sanlin19054-cyber/desktop-tutorial/vision/测试图片/组合2.jpg

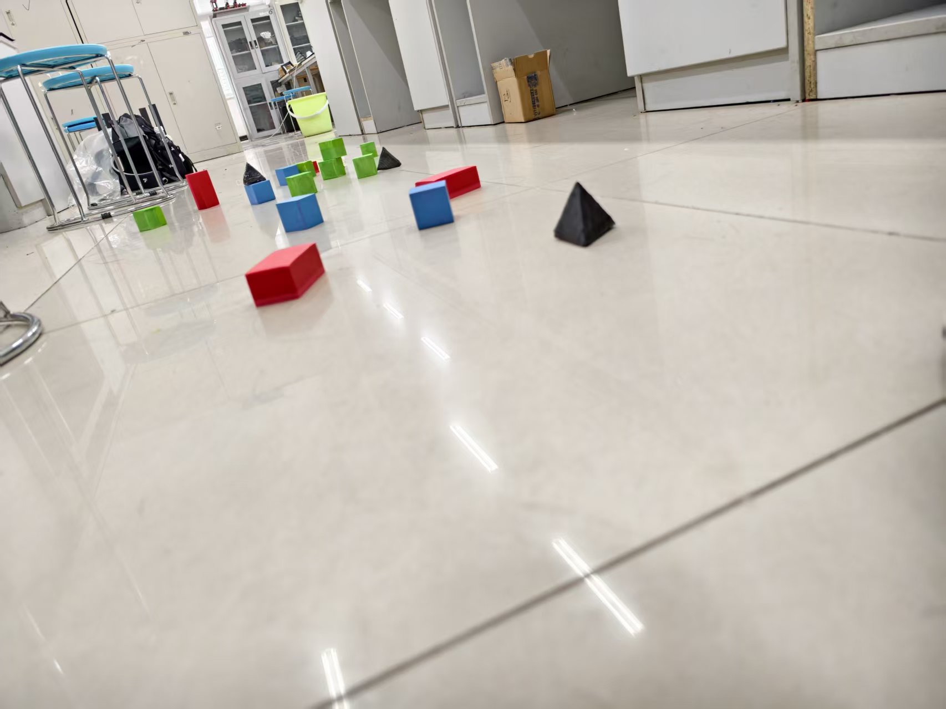
vision/测试图片/组合2.jpg
