sanlin19054-cyber/desktop-tutorial/vision/测试图片/组合3.jpg

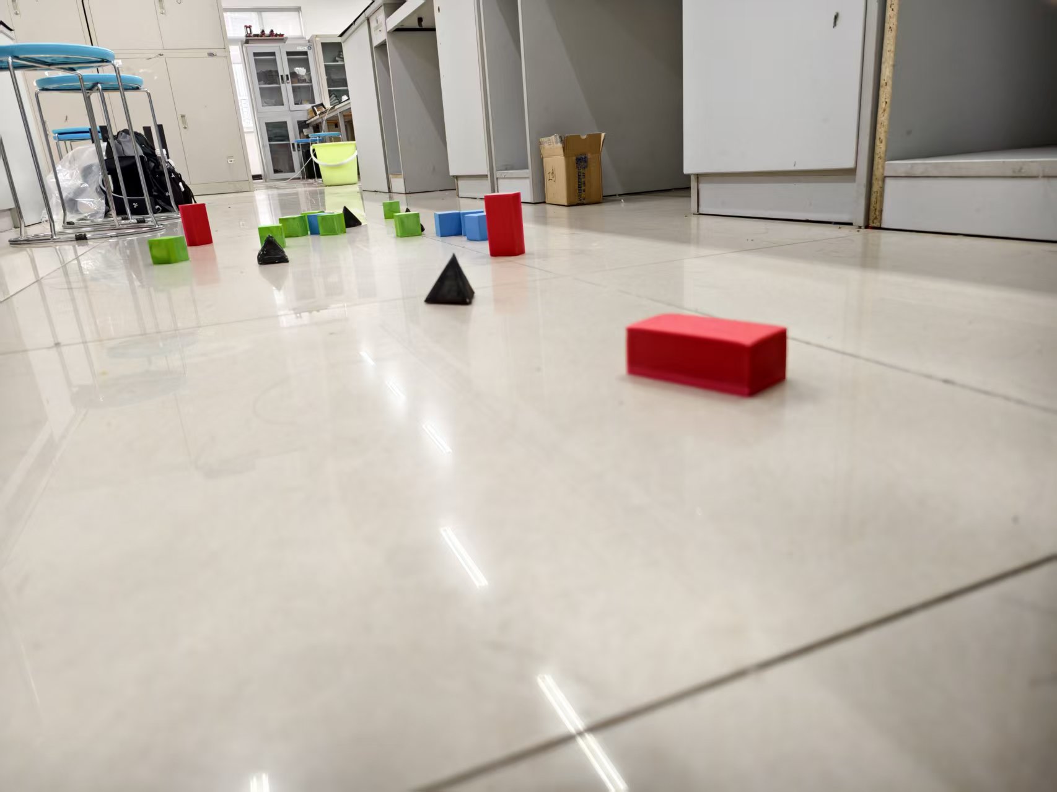
vision/测试图片/组合3.jpg
