sanlin19054-cyber/desktop-tutorial/integration/紅外測距調試記錄.md

 # 工創賽紅外測距調試記錄

> **日期**：2026年8月23日至2026年8月29日

> **主要事宜**：編碼並調試左、右紅外測距設備，測試證明成功。

> **說明**：第一次嘗試，各方面都很粗糙，所有內容僅供學習參考orz

---

## 8月23日 供电检查
### 內容概述
检查红外传感器供电线路，将VCC接系统电源、GND接系统地。
### 成果記錄
上电后传感器指示灯正常，供电电压稳定，未发现发热和接触不良现象。

---

## 8月24日 信号输出检查
### 内容概述
将红外传感器OUT接入STM32输入引脚，在传感器前方反复放置和移开障碍物。
### 成果记录
输出电平能够正常切换，STM32可以正确读取传感器状态。

---

## 8月25日 检测距离调整
### 内容概述
通过调节传感器灵敏度电位器，测试不同距离下的检测效果。
### 成果记录
调整后检测距离满足机器人使用要求，近距离触发稳定，无障碍时能够正常恢复。

---

## 8月26日 连续触发测试
### 内容概述
连续进行多次遮挡和移开测试，观察传感器输出及程序响应。
### 成果记录
传感器均能正常触发，未出现明显漏检，程序能够及时更新检测状态。

---

## 8月27日 环境光测试
### 内容概述
分别在室内照明、较暗环境和较强光线下进行测试。
### 成果记录
普通室内环境下工作稳定；强光照射时检测距离略有变化，重新调整灵敏度后恢复正常。

---

## 8月28日 抗干扰测试
### 内容概述
启动电机并同时读取红外传感器信号，检查电机工作对传感器的影响。
### 成果记录
发现偶尔出现短时波动，在程序中加入连续采样和简单滤波后，误触发现象明显减少。

---

## 8月29日 整机联调
### 内容概述
将红外传感器安装到机器人上，与STM32、电机驱动和控制程序进行整机测试。
### 成果概述
机器人能够根据红外检测结果执行相应动作，各传感器响应正常，系统整体运行稳定。
