sanlin19054-cyber/desktop-tutorial/vision/测试图片/组合1.jpg

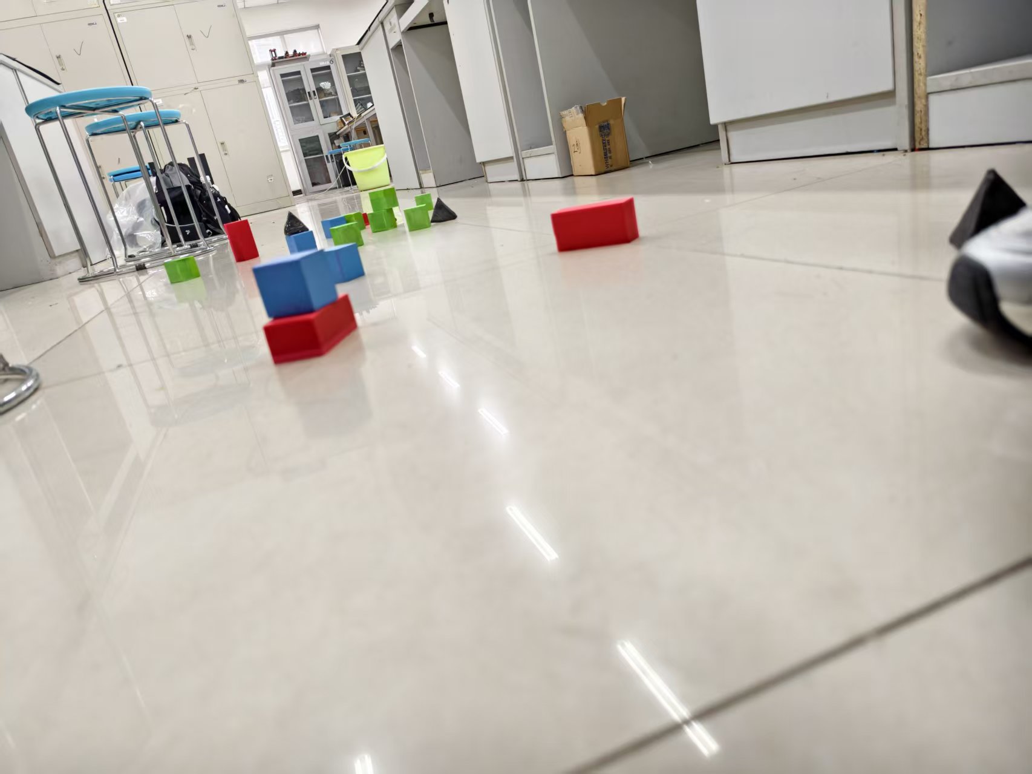
vision/测试图片/组合1.jpg
