sanlin19054-cyber/desktop-tutorial/hardware/STM32F1智能小车线束表.xlsx

Sheet: 线束总表
线号 | 类别 | 起点设备 | 起点引脚 | 起点信号 | 终点设备 | 终点引脚 | 终点信号 | 线材/连接形式 | 建议线色 | 长度 | 状态 | 备注
H1-01 | 板间排针 | 扩展板 H1 | 1 | VBAT | U1 | 20 | VBAT | 2.54mm 排针直插 | — | — | 图纸明确 | STM32 最小系统板与扩展板对应接口
H1-02 | 板间排针 | 扩展板 H1 | 2 | C13 | U1 | 19 | C13 | 2.54mm 排针直插 | — | — | 图纸明确 | STM32 最小系统板与扩展板对应接口
H1-03 | 板间排针 | 扩展板 H1 | 3 | C14 | U1 | 18 | C14 | 2.54mm 排针直插 | — | — | 图纸明确 | STM32 最小系统板与扩展板对应接口
H1-04 | 板间排针 | 扩展板 H1 | 4 | C15 | U1 | 17 | C15 | 2.54mm 排针直插 | — | — | 图纸明确 | STM32 最小系统板与扩展板对应接口
H1-05 | 板间排针 | 扩展板 H1 | 5 | A0 | U1 | 16 | A0 | 2.54mm 排针直插 | — | — | 图纸明确 | STM32 最小系统板与扩展板对应接口
H1-06 | 板间排针 | 扩展板 H1 | 6 | A1 | U1 | 15 | A1 | 2.54mm 排针直插 | — | — | 图纸明确 | STM32 最小系统板与扩展板对应接口
H1-07 | 板间排针 | 扩展板 H1 | 7 | A2 | U1 | 14 | A2 | 2.54mm 排针直插 | — | — | 图纸明确 | STM32 最小系统板与扩展板对应接口
H1-08 | 板间排针 | 扩展板 H1 | 8 | A3 | U1 | 13 | A3 | 2.54mm 排针直插 | — | — | 图纸明确 | STM32 最小系统板与扩展板对应接口
H1-09 | 板间排针 | 扩展板 H1 | 9 | A4 | U1 | 12 | A4 | 2.54mm 排针直插 | — | — | 图纸明确 | STM32 最小系统板与扩展板对应接口
H1-10 | 板间排针 | 扩展板 H1 | 10 | A5 | U1 | 11 | A5 | 2.54mm 排针直插 | — | — | 图纸明确 | STM32 最小系统板与扩展板对应接口
H1-11 | 板间排针 | 扩展板 H1 | 11 | A6 | U1 | 10 | A6 | 2.54mm 排针直插 | — | — | 图纸明确 | STM32 最小系统板与扩展板对应接口
H1-12 | 板间排针 | 扩展板 H1 | 12 | A7 | U1 | 9 | A7 | 2.54mm 排针直插 | — | — | 图纸明确 | STM32 最小系统板与扩展板对应接口
H1-13 | 板间排针 | 扩展板 H1 | 13 | B0 | U1 | 8 | B0 | 2.54mm 排针直插 | — | — | 图纸明确 | STM32 最小系统板与扩展板对应接口
H1-14 | 板间排针 | 扩展板 H1 | 14 | B1 | U1 | 7 | B1 | 2.54mm 排针直插 | — | — | 图纸明确 | STM32 最小系统板与扩展板对应接口
H1-15 | 板间排针 | 扩展板 H1 | 15 | B10 | U1 | 6 | B10 | 2.54mm 排针直插 | — | — | 图纸明确 | STM32 最小系统板与扩展板对应接口
H1-16 | 板间排针 | 扩展板 H1 | 16 | B11 | U1 | 5 | B11 | 2.54mm 排针直插 | — | — | 图纸明确 | STM32 最小系统板与扩展板对应接口
H1-17 | 板间排针 | 扩展板 H1 | 17 | RESET | U1 | 4 | RESET | 2.54mm 排针直插 | — | — | 图纸明确 | STM32 最小系统板与扩展板对应接口
H1-18 | 板间排针 | 扩展板 H1 | 18 | 3.3V | U1 | 3 | 3.3V | 2.54mm 排针直插 | — | — | 图纸明确 | STM32 最小系统板与扩展板对应接口
H1-19 | 板间排针 | 扩展板 H1 | 19 | GND | U1 | 2 | GND | 2.54mm 排针直插 | — | — | 图纸明确 | STM32 最小系统板与扩展板对应接口
H1-20 | 板间排针 | 扩展板 H1 | 20 | GND | U1 | 1 | GND | 2.54mm 排针直插 | — | — | 图纸明确 | STM32 最小系统板与扩展板对应接口
H2-01 | 板间排针 | 扩展板 H2 | 1 | B12 | U1 | 40 | B12 | 2.54mm 排针直插 | — | — | 图纸明确 | STM32 最小系统板与扩展板对应接口
H2-02 | 板间排针 | 扩展板 H2 | 2 | B13 | U1 | 39 | B13 | 2.54mm 排针直插 | — | — | 图纸明确 | STM32 最小系统板与扩展板对应接口
H2-03 | 板间排针 | 扩展板 H2 | 3 | B14 | U1 | 38 | B14 | 2.54mm 排针直插 | — | — | 图纸明确 | STM32 最小系统板与扩展板对应接口
H2-04 | 板间排针 | 扩展板 H2 | 4 | B15 | U1 | 37 | B15 | 2.54mm 排针直插 | — | — | 图纸明确 | STM32 最小系统板与扩展板对应接口
H2-05 | 板间排针 | 扩展板 H2 | 5 | A8 | U1 | 36 | A8 | 2.54mm 排针直插 | — | — | 图纸明确 | STM32 最小系统板与扩展板对应接口
H2-06 | 板间排针 | 扩展板 H2 | 6 | A9 | U1 | 35 | A9 | 2.54mm 排针直插 | — | — | 图纸明确 | STM32 最小系统板与扩展板对应接口
H2-07 | 板间排针 | 扩展板 H2 | 7 | A10 | U1 | 34 | A10 | 2.54mm 排针直插 | — | — | 图纸明确 | STM32 最小系统板与扩展板对应接口
H2-08 | 板间排针 | 扩展板 H2 | 8 | A11 | U1 | 33 | A11 | 2.54mm 排针直插 | — | — | 图纸明确 | STM32 最小系统板与扩展板对应接口
H2-09 | 板间排针 | 扩展板 H2 | 9 | A12 | U1 | 32 | A12 | 2.54mm 排针直插 | — | — | 图纸明确 | STM32 最小系统板与扩展板对应接口
H2-10 | 板间排针 | 扩展板 H2 | 10 | A15 | U1 | 31 | A15 | 2.54mm 排针直插 | — | — | 图纸明确 | STM32 最小系统板与扩展板对应接口
H2-11 | 板间排针 | 扩展板 H2 | 11 | B3 | U1 | 30 | B3 | 2.54mm 排针直插 | — | — | 图纸明确 | STM32 最小系统板与扩展板对应接口
H2-12 | 板间排针 | 扩展板 H2 | 12 | B4 | U1 | 29 | B4 | 2.54mm 排针直插 | — | — | 图纸明确 | STM32 最小系统板与扩展板对应接口
H2-13 | 板间排针 | 扩展板 H2 | 13 | B5 | U1 | 28 | B5 | 2.54mm 排针直插 | — | — | 图纸明确 | STM32 最小系统板与扩展板对应接口
H2-14 | 板间排针 | 扩展板 H2 | 14 | B6 | U1 | 27 | B6 | 2.54mm 排针直插 | — | — | 图纸明确 | STM32 最小系统板与扩展板对应接口
H2-15 | 板间排针 | 扩展板 H2 | 15 | B7 | U1 | 26 | B7 | 2.54mm 排针直插 | — | — | 图纸明确 | STM32 最小系统板与扩展板对应接口
H2-16 | 板间排针 | 扩展板 H2 | 16 | B8 | U1 | 25 | B8 | 2.54mm 排针直插 | — | — | 图纸明确 | STM32 最小系统板与扩展板对应接口
H2-17 | 板间排针 | 扩展板 H2 | 17 | B9 | U1 | 24 | B9 | 2.54mm 排针直插 | — | — | 图纸明确 | STM32 最小系统板与扩展板对应接口
H2-18 | 板间排针 | 扩展板 H2 | 18 | 5V | U1 | 23 | 5V | 2.54mm 排针直插 | — | — | 图纸明确 | STM32 最小系统板与扩展板对应接口
H2-19 | 板间排针 | 扩展板 H2 | 19 | GND | U1 | 22 | GND | 2.54mm 排针直插 | — | — | 图纸明确 | STM32 最小系统板与扩展板对应接口
H2-20 | 板间排针 | 扩展板 H2 | 20 | 3.3V | U1 | 21 | 3.3V | 2.54mm 排针直插 | — | — | 图纸明确 | STM32 最小系统板与扩展板对应接口
U2-1 | 显示 | 扩展板 U2 / 0.96 OLED | 1 | GND | OLED 模块 | 1 | GND | 4P 2.54mm | 黑 | 图纸未规定 | 待复核 | 模块引脚标注 GND；原理图未在该引脚处形成显式 GND 网络，装配前复核。
U2-2 | 显示 | 扩展板 U2 / 0.96 OLED | 2 | VCC | OLED 模块 | 2 | 5V | 4P 2.54mm | 红 | 图纸未规定 | 图纸明确
U2-3 | 显示 | 扩展板 U2 / 0.96 OLED | 3 | SCL | OLED 模块 | 3 | A11 | 4P 2.54mm | 黄/绿 | 图纸未规定 | 图纸明确
U2-4 | 显示 | 扩展板 U2 / 0.96 OLED | 4 | SDA | OLED 模块 | 4 | A12 | 4P 2.54mm | 黄/绿 | 图纸未规定 | 图纸明确
A1-2 | 蓝牙 | 扩展板 A1 / JDY-31 | 2 | RXD | JDY-31 模块 | 2 | A9 | 2.54mm | 信号色 | 图纸未规定 | 图纸明确
A1-3 | 蓝牙 | 扩展板 A1 / JDY-31 | 3 | TXD | JDY-31 模块 | 3 | A10 | 2.54mm | 信号色 | 图纸未规定 | 图纸明确
A1-4 | 蓝牙 | 扩展板 A1 / JDY-31 | 4 | GND | JDY-31 模块 | 4 | GND | 2.54mm | 黑 | 图纸未规定 | 图纸明确 | 原理图未形成从该引脚到 GND 网络的有效连线，请以实物/PCB复核。
A1-5 | 蓝牙 | 扩展板 A1 / JDY-31 | 5 | VCC | JDY-31 模块 | 5 | 5V | 2.54mm | 红 | 图纸未规定 | 图纸明确
A1-1 | 蓝牙 | 扩展板 A1 / JDY-31 | 1 | STATE | JDY-31 模块 | 1 | NC | 2.54mm | 信号色 | 图纸未规定 | 未接/待确认
A1-6 | 蓝牙 | 扩展板 A1 / JDY-31 | 6 | EN | JDY-31 模块 | 6 | NC | 2.54mm | 信号色 | 图纸未规定 | 未接/待确认
H9-2 | 树莓派串口 | 扩展板 H9 | 2 | A2 | 树莓派 | TX→树莓派 RX | TX→树莓派 RX | 2.54mm 3P | 信号色 | 图纸未规定 | 图纸明确 | 原理图文字明确标注“树莓派接口”；H9 的 A2/A3 对应串口信号。
H9-3 | 树莓派串口 | 扩展板 H9 | 3 | A3 | 树莓派 | RX←树莓派 TX | RX←树莓派 TX | 2.54mm 3P | 信号色 | 图纸未规定 | 图纸明确 | 原理图文字明确标注“树莓派接口”；H9 的 A2/A3 对应串口信号。
H9-1 | 树莓派串口 | 扩展板 H9 | 1 | NC | 树莓派 | 未定义 | 未定义 | 2.54mm 3P | 信号色 | 图纸未规定 | 未接/待确认 | H9 Pin1 在原理图中未定义；未提供明确 GND/5V。
H5-1 | 传感器/IO | 扩展板 H5 | 1 | A0 | 图纸未命名外设 | SIG | A0 | 图纸未规定 | 信号色 | 图纸未规定 | 图纸明确
H5-2 | 传感器/IO | 扩展板 H5 | 2 | 5V | 外部传感器 | VCC | 5V | 2.54mm 3P | 红 | 图纸未规定 | 图纸明确
H5-3 | 传感器/IO | 扩展板 H5 | 3 | NC | 外部传感器 | — | NC | 2.54mm 3P | — | 图纸未规定 | 未接/待确认
H7-1 | 传感器/IO | 扩展板 H7 | 1 | 5V | 外部模块 | VCC | 5V | 2.54mm 4P | 红 | 图纸未规定 | 图纸明确
H7-2 | 传感器/IO | 扩展板 H7 | 2 | A4 | 外部模块 | SIG | A4 | 2.54mm 4P | 信号色 | 图纸未规定 | 图纸明确
H7-3 | 传感器/IO | 扩展板 H7 | 3 | A5 | 外部模块 | SIG | A5 | 2.54mm 4P | 信号色 | 图纸未规定 | 图纸明确
H7-4 | 传感器/IO | 扩展板 H7 | 4 | NC | 外部模块 | — | NC | 2.54mm 4P | — | 图纸未规定 | 未接/待确认
H8-1 | 右避障/IO | 扩展板 H8 | 1 | 5V | 右侧避障模块 | VCC | 5V | 2.54mm 3P | 红 | 图纸未规定 | 图纸明确 | PCB丝印区域标注“右避障”。
H8-2 | 右避障/IO | 扩展板 H8 | 2 | NC | 右侧避障模块 | — | NC | 2.54mm 3P | — | 图纸未规定 | 未接/待确认
H8-3 | 右避障/IO | 扩展板 H8 | 3 | B12 | 右侧避障模块 | SIG | B12 | 2.54mm 3P | 信号色 | 图纸未规定 | 图纸明确 | PCB丝印区域标注“右避障”。
H6-1 | 左避障/IO | 扩展板 H6 | 1 | 5V | 左侧避障模块 | VCC | 5V | 2.54mm 3P | 红 | 图纸未规定 | 图纸明确 | PCB丝印区域标注“左避障”。
H6-2 | 左避障/IO | 扩展板 H6 | 2 | NC | 左侧避障模块 | — | NC | 2.54mm 3P | — | 图纸未规定 | 未接/待确认
H6-3 | 左避障/IO | 扩展板 H6 | 3 | B13 | 左侧避障模块 | SIG | B13 | 2.54mm 3P | 信号色 | 图纸未规定 | 图纸明确 | PCB丝印区域标注“左避障”。
CN6-1 | 多路IO | 扩展板 CN6 | 1 | 5V | 外部模块 | VCC | 5V | KF2510 6P | 红 | 图纸未规定 | 图纸明确
CN6-2 | 多路IO | 扩展板 CN6 | 2 | B0 | 外部模块 | SIG | B0 | KF2510 6P | 信号色 | 图纸未规定 | 图纸明确
CN6-3 | 多路IO | 扩展板 CN6 | 3 | B1 | 外部模块 | SIG | B1 | KF2510 6P | 信号色 | 图纸未规定 | 图纸明确
CN6-4 | 多路IO | 扩展板 CN6 | 4 | B10 | 外部模块 | SIG | B10 | KF2510 6P | 信号色 | 图纸未规定 | 图纸明确
CN6-5 | 多路IO | 扩展板 CN6 | 5 | B11 | 外部模块 | SIG | B11 | KF2510 6P | 信号色 | 图纸未规定 | 图纸明确
CN6-6 | 多路IO | 扩展板 CN6 | 6 | NC | 外部模块 | — | NC | KF2510 6P | — | 图纸未规定 | 未接/待确认
U11-1 | 电机驱动 | 扩展板 U11 / TB6612 | VM(1) | IN+ | TB6612 模块 | VM | IN+ | 动力电源 | 红 | 图纸未规定 | 图纸明确
U11-2 | 电机驱动 | 扩展板 U11 / TB6612 | VCC(2) | 5V | TB6612 模块 | VCC | 5V | 逻辑电源 | 红 | 图纸未规定 | 图纸明确
U11-3 | 电机驱动 | 扩展板 U11 / TB6612 | GND(3) | GND | TB6612 模块 | GND | GND | 地线 | 黑 | 图纸未规定 | 待复核 | 元件引脚标注 GND，但原理图未形成显式 GND 网络。
U11-4 | 电机输出 | 扩展板 U11 / TB6612 | AO1(4) | AO1 | U7/U8 电机接口 | Pin1 | AO1 | 动力线 | 按电机电流选型 | 图纸未规定 | 图纸明确 | U7 与 U8 的同名网络并联。
U11-5 | 电机输出 | 扩展板 U11 / TB6612 | AO2(5) | AO2 | U7/U8 电机接口 | Pin2 | AO2 | 动力线 | 按电机电流选型 | 图纸未规定 | 图纸明确 | U7 与 U8 的同名网络并联。
U11-6 | 电机输出 | 扩展板 U11 / TB6612 | BO2(6) | BO2 | U9/U10 电机接口 | 对应并联端 | BO2 | 动力线 | 按电机电流选型 | 图纸未规定 | 图纸明确 | U9 与 U10 的同名网络并联。
U11-7 | 电机输出 | 扩展板 U11 / TB6612 | BO1(7) | BO1 | U9/U10 电机接口 | 对应并联端 | BO1 | 动力线 | 按电机电流选型 | 图纸未规定 | 图纸明确 | U9 与 U10 的同名网络并联。
U11-8 | 电机驱动 | 扩展板 U11 / TB6612 | GND(8) | GND | TB6612 模块 | GND | GND | 地线 | 黑 | 图纸未规定 | 待复核 | 元件引脚标注 GND，但原理图未形成显式 GND 网络。
U11-9 | 电机驱动 | 扩展板 U11 / TB6612 | GND(9) | GND | TB6612 模块 | GND | GND | 地线 | 黑 | 图纸未规定 | 待复核 | 元件引脚标注 GND，但原理图未形成显式 GND 网络。
U11-10 | 控制 | 扩展板 U11 / TB6612 | PWMB(10) | A6 | STM32 | PA6 | A6 | 信号线 | 信号色 | 图纸未规定 | 图纸明确
U11-11 | 控制 | 扩展板 U11 / TB6612 | BIN2(11) | B8 | STM32 | PB8 | B8 | 信号线 | 信号色 | 图纸未规定 | 图纸明确
U11-12 | 控制 | 扩展板 U11 / TB6612 | BIN1(12) | B7 | STM32 | PB7 | B7 | 信号线 | 信号色 | 图纸未规定 | 图纸明确
U11-13 | 控制 | 扩展板 U11 / TB6612 | STBY(13) | 5V | TB6612 模块 | STBY | 5V | 逻辑线 | 红 | 图纸未规定 | 图纸明确
U11-14 | 控制 | 扩展板 U11 / TB6612 | AIN1(14) | B6 | STM32 | PB6 | B6 | 信号线 | 信号色 | 图纸未规定 | 图纸明确
U11-15 | 控制 | 扩展板 U11 / TB6612 | AIN2(15) | B5 | STM32 | PB5 | B5 | 信号线 | 信号色 | 图纸未规定 | 图纸明确
U11-16 | 控制 | 扩展板 U11 / TB6612 | PWMA(16) | A7 | STM32 | PA7 | A7 | 信号线 | 信号色 | 图纸未规定 | 图纸明确
U7-1 | 电机接口 | U7 | 1 | AO1 | 左/甲电机端 | A+ | AO1 | 2P 5.08mm | 动力线 | 图纸未规定 | 图纸明确
U7-2 | 电机接口 | U7 | 2 | AO2 | 左/甲电机端 | A- | AO2 | 2P 5.08mm | 动力线 | 图纸未规定 | 图纸明确
U8-1 | 电机接口 | U8 | 1 | AO1 | 左/甲电机端 | A+ | AO1 | 2P 5.08mm | 动力线 | 图纸未规定 | 图纸明确 | 与 U7 并联，同一 AO1 网络。
U8-2 | 电机接口 | U8 | 2 | AO2 | 左/甲电机端 | A- | AO2 | 2P 5.08mm | 动力线 | 图纸未规定 | 图纸明确 | 与 U7 并联，同一 AO2 网络。
U9-1 | 电机接口 | U9 | 1 | BO1 | 右/乙电机端 | B+ | BO1 | 2P 5.08mm | 动力线 | 图纸未规定 | 图纸明确 | 与 U10 的 BO1/BO2 网络并联；具体极性按实车电机转向校验。
U9-2 | 电机接口 | U9 | 2 | BO2 | 右/乙电机端 | B- | BO2 | 2P 5.08mm | 动力线 | 图纸未规定 | 图纸明确
U10-1 | 电机接口 | U10 | 1 | BO2 | 右/乙电机端 | B- | BO2 | 2P 5.08mm | 动力线 | 图纸未规定 | 图纸明确 | 与 U9 并联。
U10-2 | 电机接口 | U10 | 2 | BO1 | 右/乙电机端 | B+ | BO1 | 2P 5.08mm | 动力线 | 图纸未规定 | 图纸明确 | 与 U9 并联。
PWR-01 | 电源 | CN5 | 1 | 电池负极 / U3 IN- | U3 | IN-(2) | IN- | 动力电源线 | 黑 | 图纸未规定 | 图纸明确 | CN5 Pin1 与 U3 IN- 相连。
PWR-02 | 电源 | CN5 | 2 | 电池正极 | U5 | Pin1 | 开关输入 | 动力电源线 | 红 | 图纸未规定 | 图纸明确
PWR-03 | 电源 | U5 | Pin2 | IN+（开关后） | U3 | IN+(1) | IN+ | 动力电源线 | 红 | 图纸未规定 | 图纸明确 | 同一 IN+ 网络还供给 H4 Pin1 与 TB6612 VM。
PWR-04 | 电源 | U3 | OUT+ (3) | 5V | 5V 电源网络 | 5V | 5V | 电源 | 红 | 图纸未规定 | 图纸明确 | 5V 经扩展板分配到 H3/H5/H6/H7/H8/CN6/U2/A1/U11 等。
PWR-05 | 电源 | U3 | OUT- (4) | OUT- | 电源负端 | GND | GND | 电源 | 黑 | 图纸未规定 | 待复核 | 原理图中 U3 OUT- 未形成显式 GND 网络；PCB/实物装配前必须复核。
PWR-06 | 动力电源 | H4 | 1 | IN+ | TB6612 U11 | VM(1) | IN+ | 2P 2.54/5.08mm | 红 | 图纸未规定 | 图纸明确 | H4 Pin1 标注为 IN+，对应 TB6612 VM 网络。
PWR-07 | 动力电源 | H4 | 2 | NC | — | — | NC | 2P 2.54/5.08mm | — | — | 未接/待确认 | 原理图未给出有效网络。

Sheet: 接口定义
接口/器件 | 类型 | Pin | 信号/网络 | 功能/外接对象 | 状态 | 备注
H1 | STM32板间接口 | 1 | VBAT | U1 Pin20 | 明确 | 2.54mm 20P
H1 | STM32板间接口 | 2 | C13 | U1 Pin19 | 明确
H1 | STM32板间接口 | 3 | C14 | U1 Pin18 | 明确
H1 | STM32板间接口 | 4 | C15 | U1 Pin17 | 明确
H1 | STM32板间接口 | 5 | A0 | U1 Pin16 | 明确
H1 | STM32板间接口 | 6 | A1 | U1 Pin15 | 明确
H1 | STM32板间接口 | 7 | A2 | U1 Pin14 | 明确
H1 | STM32板间接口 | 8 | A3 | U1 Pin13 | 明确
H1 | STM32板间接口 | 9 | A4 | U1 Pin12 | 明确
H1 | STM32板间接口 | 10 | A5 | U1 Pin11 | 明确
H1 | STM32板间接口 | 11 | A6 | U1 Pin10 | 明确
H1 | STM32板间接口 | 12 | A7 | U1 Pin9 | 明确
H1 | STM32板间接口 | 13 | B0 | U1 Pin8 | 明确
H1 | STM32板间接口 | 14 | B1 | U1 Pin7 | 明确
H1 | STM32板间接口 | 15 | B10 | U1 Pin6 | 明确
H1 | STM32板间接口 | 16 | B11 | U1 Pin5 | 明确
H1 | STM32板间接口 | 17 | RESET | U1 Pin4 | 明确
H1 | STM32板间接口 | 18 | 3.3V | U1 Pin3 | 明确
H1 | STM32板间接口 | 19 | GND | U1 Pin2 | 明确
H1 | STM32板间接口 | 20 | GND | U1 Pin1 | 明确
H2 | STM32板间接口 | 1 | B12 | U1 Pin40 | 明确 | 2.54mm 20P
H2 | STM32板间接口 | 2 | B13 | U1 Pin39 | 明确
H2 | STM32板间接口 | 3 | B14 | U1 Pin38 | 明确
H2 | STM32板间接口 | 4 | B15 | U1 Pin37 | 明确
H2 | STM32板间接口 | 5 | A8 | U1 Pin36 | 明确
H2 | STM32板间接口 | 6 | A9 | U1 Pin35 | 明确
H2 | STM32板间接口 | 7 | A10 | U1 Pin34 | 明确
H2 | STM32板间接口 | 8 | A11 | U1 Pin33 | 明确
H2 | STM32板间接口 | 9 | A12 | U1 Pin32 | 明确
H2 | STM32板间接口 | 10 | A15 | U1 Pin31 | 明确
H2 | STM32板间接口 | 11 | B3 | U1 Pin30 | 明确
H2 | STM32板间接口 | 12 | B4 | U1 Pin29 | 明确
H2 | STM32板间接口 | 13 | B5 | U1 Pin28 | 明确
H2 | STM32板间接口 | 14 | B6 | U1 Pin27 | 明确
H2 | STM32板间接口 | 15 | B7 | U1 Pin26 | 明确
H2 | STM32板间接口 | 16 | B8 | U1 Pin25 | 明确
H2 | STM32板间接口 | 17 | B9 | U1 Pin24 | 明确
H2 | STM32板间接口 | 18 | 5V | U1 Pin23 | 明确
H2 | STM32板间接口 | 19 | GND | U1 Pin22 | 明确
H2 | STM32板间接口 | 20 | 3.3V | U1 Pin21 | 明确
U2 | 0.96 OLED | 1 | GND | OLED GND | 待复核 | PCB器件引脚标注 GND；原理图未显式拉到 GND 网络
U2 | 0.96 OLED | 2 | 5V | OLED VCC | 明确 | I²C模块
U2 | 0.96 OLED | 3 | A11 | OLED SCL | 明确 | I²C
U2 | 0.96 OLED | 4 | A12 | OLED SDA | 明确 | I²C
A1 | JDY-31 | 1 | STATE | 状态脚 | 未接/待确认
A1 | JDY-31 | 2 | A9 | RXD | 明确
A1 | JDY-31 | 3 | A10 | TXD | 明确
A1 | JDY-31 | 4 | GND | GND | 待复核 | 模块脚标为 GND；原理图未显式接 GND
A1 | JDY-31 | 5 | 5V | VCC | 明确
A1 | JDY-31 | 6 | EN | 使能脚 | 未接/待确认
H9 | 树莓派接口 | 1 | NC | 未定义 | 未接/待确认
H9 | 树莓派接口 | 2 | A2 | TX→树莓派RX | 明确
H9 | 树莓派接口 | 3 | A3 | RX←树莓派TX | 明确
U11 | TB6612FNG | 1 | IN+ / VM | 动力电源 | 明确
U11 | TB6612FNG | 2 | 5V / VCC | 逻辑电源 | 明确
U11 | TB6612FNG | 3 | GND | 逻辑地 | 待复核 | 图中未形成显式 GND 网络
U11 | TB6612FNG | 4 | AO1 | A路电机 | 明确
U11 | TB6612FNG | 5 | AO2 | A路电机 | 明确
U11 | TB6612FNG | 6 | BO2 | B路电机 | 明确
U11 | TB6612FNG | 7 | BO1 | B路电机 | 明确
U11 | TB6612FNG | 8 | GND | 动力地 | 待复核 | 图中未形成显式 GND 网络
U11 | TB6612FNG | 9 | GND | 动力地 | 待复核 | 图中未形成显式 GND 网络
U11 | TB6612FNG | 10 | A6 | PWMB | 明确
U11 | TB6612FNG | 11 | B8 | BIN2 | 明确
U11 | TB6612FNG | 12 | B7 | BIN1 | 明确
U11 | TB6612FNG | 13 | 5V | STBY | 明确
U11 | TB6612FNG | 14 | B6 | AIN1 | 明确
U11 | TB6612FNG | 15 | B5 | AIN2 | 明确
U11 | TB6612FNG | 16 | A7 | PWMA | 明确

Sheet: 图纸复核
编号 | 对象 | 问题/现象 | 线束处理建议 | 优先级
R01 | U2 OLED Pin1 | 引脚标注 GND，但原理图连接未形成显式 GND 网络 | 装配时确认模块 Pin1 确实接系统 GND；不要仅依据原理图裸连 | 高
R02 | A1 JDY-31 Pin4 | 引脚标注 GND，但原理图未形成显式 GND 网络 | 必须在实物接线前复核 GND；与 STM32/扩展板共地 | 高
R03 | U11 TB6612 Pin3/8/9 | 三个引脚标注 GND，但原理图未形成显式 GND 网络 | 确认 PCB/模块实际已接 GND；否则驱动器无法正常工作 | 高
R04 | U3 OUT- | 5V 降压模块 OUT- 未形成显式 GND 网络 | 确认 OUT- 与系统 GND 的关系；上电前必须复核 | 高
R05 | H5/H6/H8/H7/H9/CN6 等 NC | 部分接口存在未定义/未连接引脚 | 按当前图纸视为 NC；如实物模块需要 GND/电源，必须先更新原理图再装配 | 中
R06 | U7/U8、U9/U10 | 两组电机端子为并联网络 | 同一电机回路不要同时插入两个并联端子；确认电机极性后统一编号 | 中
R07 | CN5/U5/U3/H4/U11 | 动力电源链路存在 IN+ 分配 | 建议在实物线束上给电池正极、开关后正极、驱动 VM 分别做标签 | 中
R08 | 线长/线径/颜色 | 原始图纸未给出线长、线径、线色 | 本表给出的是装配建议；最终尺寸应按车体实装测量、按负载电流选线径 | 中
