sanlin19054-cyber/desktop-tutorial/hardware/BOM_STM32F1智能小车扩展板_2026-08-18.csv

ID | Name | Designator | Footprint | Quantity | Manufacturer Part | Manufacturer | Supplier | Supplier Part | Price
1 | JDY-31(6针) | A1 | JDY-31(针2.54) | 1 |  |  | 16LAB
2 | 220uF | C4 | CAP-TH_BD10.0-P5.00-D1.0-RNG221M1EBK-1012 | 1
3 | 100nF | C5,C6 | C0805 | 2 | C0805B104J250NT | TORCH(火炬) | LCSC | C17702771 | 0.0504
4 | HDR-F-2.54_1x2 | CN5 | CONN-TH_KF2510-2P | 1 |  |  | LCSC | C49661 | 0.3984
5 | KH-2.54FH-1X6P-H8.5 | CN6 | CONN-TH_KF2510-6P | 1 | KH-2.54FH-1X6P-H8.5 | kinghelm(金航标) | LCSC | C2905416 | 0.5874
6 | KH-2.54FH-1X20P-H8.5 | H1,H2 | HDR-TH_20P-P2.54-V-F-2 | 2 | KH-2.54FH-1X20P-H8.5 | kinghelm(金航标) | LCSC | C2905423 | 1.5096
7 | H3 | H3 | HDR-M-2.54_2X5 | 1 | 1761683-3 | TE Connectivity(泰科电子) | LCSC | C17200487 | 19.85
8 | HDR-F-2.54_1x2 | H4,U7,U8,U9,U10 | CONN-TH_2P-P5.08_HX50801-2A | 5 |  |  | LCSC | C49661 | 0.3984
9 | XY-2.54-1*3PZ | H5,H6,H8,H9 | HDR-TH_XY-2.54-1X3PZ | 4 | XY-2.54-1*3PZ | XYECONN(辛译) | LCSC | C54110157 | 0.0779
10 | H7 | H7 | HDR-M-2.54_1X4 | 1 | KH-2.54FH-1X4P-H8.5 | kinghelm(金航标) | LCSC | C2905415 | 0.5118
11 | 4.7kΩ | R1,R2 | R0805 | 2 | RMC08054.7K1%N | Tyohm(幸亚电阻) | LCSC | C269746 | 0.0471
12 | STM32F103C8T6最小系统板原理图 | U1 | STM32F103C8T6最小系统板PCB图 | 1 |  |  | LCSC
13 | 0.96OLED_4P_MODULE_JX | U2 | 0.96OLED_4P | 1 | 0.96OLED_4P_MODULE_JX | null | LCSC | C9900004566
14 | MINI5605V5A输出电源模块 | U3 | COMM-SMD_MINI5605V5A | 1 | mini5605V5A输出电源模块 | null | LCSC | C9900015474
15 | HX SS12D10G5-WJ | U5 | SW-TH_3P-P4.80_HX-SS12D10G5-WJ | 1 | HX SS12D10G5-WJ | hanxia(韩下) | LCSC | C19189124 | 1.2893
16 | TB6612FNG_Module | U11 | TB6612FNG_MODULE | 1
