sanlin19054-cyber/desktop-tutorial/integration/rescue_robot_f407_ir_final_20260823/main.c

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
/* Includes ------------------------------------------------------------------*/
#include "main.h"
#include "dma.h"
#include "tim.h"
#include "usart.h"
#include "gpio.h"

/* USER CODE BEGIN Includes */
#include "pi_protocol.h"
#include "stp23l.h"
/* USER CODE END Includes */


/* USER CODE BEGIN PV */
static uint32_t telemetry_tick = 0;
static PiProtocol pi_protocol;
static uint8_t pi_motor_command_active = 0U;
static Stp23l stp_left;
static Stp23l stp_right;

#define STP23L_TELEMETRY_MAX_AGE_MS 300U

/* ST-LINK debugger watch variables. 0xFFFF means invalid or stale. */
volatile uint16_t stp_left_distance_mm = STP23L_INVALID_DISTANCE_MM;
volatile uint16_t stp_right_distance_mm = STP23L_INVALID_DISTANCE_MM;
volatile uint8_t stp_distance_valid_mask = 0U;
volatile uint8_t stp_left_confidence = 0U;
volatile uint8_t stp_right_confidence = 0U;
volatile uint32_t stp_left_frame_count = 0U;
volatile uint32_t stp_right_frame_count = 0U;
volatile uint32_t stp_left_invalid_frame_count = 0U;
volatile uint32_t stp_right_invalid_frame_count = 0U;
volatile uint32_t stp_left_uart_error_count = 0U;
volatile uint32_t stp_right_uart_error_count = 0U;
/* USER CODE END PV */

void SystemClock_Config(void);
/* USER CODE BEGIN 0 */
#define MOTOR_MAX_CMD 1000

/**
 * Command range: -1000 to 1000.
 * Positive drives forward, negative drives backward, zero stops.
 */
static void Motor_WritePair(TIM_HandleTypeDef *htim,
                            uint32_t channel_a,
                            uint32_t channel_b,
                            int16_t command)
{
    uint32_t pulse;
    uint32_t arr = __HAL_TIM_GET_AUTORELOAD(htim);

    if (command > MOTOR_MAX_CMD)
        command = MOTOR_MAX_CMD;
    else if (command < -MOTOR_MAX_CMD)
        command = -MOTOR_MAX_CMD;

    if (command > 0)
    {
        pulse = ((uint32_t)command * arr) / MOTOR_MAX_CMD;

        __HAL_TIM_SET_COMPARE(htim, channel_a, pulse);
        __HAL_TIM_SET_COMPARE(htim, channel_b, 0);
    }
    else if (command < 0)
    {
        pulse = ((uint32_t)(-command) * arr) / MOTOR_MAX_CMD;

        __HAL_TIM_SET_COMPARE(htim, channel_a, 0);
        __HAL_TIM_SET_COMPARE(htim, channel_b, pulse);
    }
    else
    {
        /* Set both bridge inputs to zero to stop the motor. */
        __HAL_TIM_SET_COMPARE(htim, channel_a, 0);
        __HAL_TIM_SET_COMPARE(htim, channel_b, 0);
    }
}

static void Motor_Set(uint8_t motor_id, int16_t command)
{
    switch (motor_id)
    {
        case 1:
            Motor_WritePair(&htim1,
                            TIM_CHANNEL_1,
                            TIM_CHANNEL_2,
                            command);
            break;

        case 2:
            Motor_WritePair(&htim1,
                            TIM_CHANNEL_3,
                            TIM_CHANNEL_4,
                            command);
            break;

        case 3:
            Motor_WritePair(&htim8,
                            TIM_CHANNEL_1,
                            TIM_CHANNEL_2,
                            command);
            break;

        default:
            break;
    }
}

static void Motor_StopAll(void)
{
    Motor_Set(1, 0);
    Motor_Set(2, 0);
    Motor_Set(3, 0);
}


/* Encoder debug values visible in the debugger. */
volatile int32_t encoder_delta_1 = 0;
volatile int32_t encoder_delta_2 = 0;
volatile int32_t encoder_delta_3 = 0;

static uint32_t encoder_last_1 = 0;
static uint16_t encoder_last_2 = 0;
static uint16_t encoder_last_3 = 0;
static uint32_t encoder_sample_tick = 0;

static void Encoder_Update(void)
{
    uint32_t now_1;
    uint16_t now_2;
    uint16_t now_3;

    /* TIM2 is a 32-bit timer. */
    now_1 = __HAL_TIM_GET_COUNTER(&htim2);
    encoder_delta_1 = (int32_t)(now_1 - encoder_last_1);
    encoder_last_1 = now_1;

    /* The int16_t conversion handles TIM3/TIM4 16-bit wraparound. */
    now_2 = (uint16_t)__HAL_TIM_GET_COUNTER(&htim3);
    encoder_delta_2 = (int16_t)(now_2 - encoder_last_2);
    encoder_last_2 = now_2;

    now_3 = (uint16_t)__HAL_TIM_GET_COUNTER(&htim4);
    encoder_delta_3 = (int16_t)(now_3 - encoder_last_3);
    encoder_last_3 = now_3;
}
/* USER CODE END 0 */

/**
  * @brief  The application entry point.
  * @retval int
  */
int main(void)
{
  /* MCU Configuration--------------------------------------------------------*/

  /* Reset of all peripherals, Initializes the Flash interface and the Systick. */
  HAL_Init();

  /* Configure the system clock */
  SystemClock_Config();

  /* Initialize all configured peripherals */
  MX_GPIO_Init();
  MX_DMA_Init();
  MX_TIM1_Init();
  MX_TIM2_Init();
  MX_TIM3_Init();
  MX_TIM4_Init();
  MX_TIM8_Init();
  MX_USART1_UART_Init();
  MX_USART2_UART_Init();
  MX_USART3_UART_Init();
  /* USER CODE BEGIN 2 */
  /* Keep all PWM outputs at zero to prevent movement at power-up. */
  __HAL_TIM_SET_COMPARE(&htim1, TIM_CHANNEL_1, 0);
  __HAL_TIM_SET_COMPARE(&htim1, TIM_CHANNEL_2, 0);
  __HAL_TIM_SET_COMPARE(&htim1, TIM_CHANNEL_3, 0);
  __HAL_TIM_SET_COMPARE(&htim1, TIM_CHANNEL_4, 0);
  __HAL_TIM_SET_COMPARE(&htim8, TIM_CHANNEL_1, 0);
  __HAL_TIM_SET_COMPARE(&htim8, TIM_CHANNEL_2, 0);

  /* Start six PWM channels. */
  HAL_TIM_PWM_Start(&htim1, TIM_CHANNEL_1);
  HAL_TIM_PWM_Start(&htim1, TIM_CHANNEL_2);
  HAL_TIM_PWM_Start(&htim1, TIM_CHANNEL_3);
  HAL_TIM_PWM_Start(&htim1, TIM_CHANNEL_4);
  HAL_TIM_PWM_Start(&htim8, TIM_CHANNEL_1);
  HAL_TIM_PWM_Start(&htim8, TIM_CHANNEL_2);
  /* Start three encoder interfaces. */
  HAL_TIM_Encoder_Start(&htim2, TIM_CHANNEL_ALL);
  HAL_TIM_Encoder_Start(&htim3, TIM_CHANNEL_ALL);
  HAL_TIM_Encoder_Start(&htim4, TIM_CHANNEL_ALL);

  Motor_StopAll();

  encoder_last_1 = __HAL_TIM_GET_COUNTER(&htim2);
  encoder_last_2 = (uint16_t)__HAL_TIM_GET_COUNTER(&htim3);
  encoder_last_3 = (uint16_t)__HAL_TIM_GET_COUNTER(&htim4);
  encoder_sample_tick = HAL_GetTick();
  PiProtocol_Init(&pi_protocol, &huart1);
  if (PiProtocol_Start(&pi_protocol) != HAL_OK)
  {
      Error_Handler();
  }
  Stp23l_Init(&stp_left, &huart2);
  Stp23l_Init(&stp_right, &huart3);
  if (Stp23l_Start(&stp_left) != HAL_OK)
  {
      Error_Handler();
  }
  if (Stp23l_Start(&stp_right) != HAL_OK)
  {
      Error_Handler();
  }
  /* USER CODE END 2 */

  /* Infinite loop */
  /* USER CODE BEGIN WHILE */
  while (1)
  {
    /* USER CODE END WHILE */

    /* USER CODE BEGIN 3 */
	  {
	      uint32_t now_ms = HAL_GetTick();
	      uint8_t valid_mask = 0U;
	      uint16_t left_distance = STP23L_INVALID_DISTANCE_MM;
	      uint16_t right_distance = STP23L_INVALID_DISTANCE_MM;

	      Stp23l_Service(&stp_left);
	      Stp23l_Service(&stp_right);
	      if (
	          Stp23l_GetDistance(
	              &stp_left,
	              now_ms,
	              STP23L_TELEMETRY_MAX_AGE_MS,
	              &left_distance
	          ) != 0U
	      )
	      {
	          valid_mask |= 0x01U;
	      }
	      if (
	          Stp23l_GetDistance(
	              &stp_right,
	              now_ms,
	              STP23L_TELEMETRY_MAX_AGE_MS,
	              &right_distance
	          ) != 0U
	      )
	      {
	          valid_mask |= 0x02U;
	      }
	      stp_left_distance_mm = left_distance;
	      stp_right_distance_mm = right_distance;
	      stp_distance_valid_mask = valid_mask;
	      stp_left_confidence = stp_left.confidence;
	      stp_right_confidence = stp_right.confidence;
	      stp_left_frame_count = stp_left.frame_count;
	      stp_right_frame_count = stp_right.frame_count;
	      stp_left_invalid_frame_count = stp_left.invalid_frame_count;
	      stp_right_invalid_frame_count = stp_right.invalid_frame_count;
	      stp_left_uart_error_count = stp_left.uart_error_count;
	      stp_right_uart_error_count = stp_right.uart_error_count;
	  }
	  if ((HAL_GetTick() - encoder_sample_tick) >= 10)
	  	  {
	  	      encoder_sample_tick = HAL_GetTick();
	  	      Encoder_Update();
	  	  }
      {
          PiMotorCommand command;
          if (PiProtocol_TakeMotorCommand(&pi_protocol, &command) != 0U)
          {
              Motor_Set(1, command.motor_1);
              Motor_Set(2, command.motor_2);
              Motor_Set(3, command.motor_3);
              pi_motor_command_active =
                  ((command.motor_1 != 0) ||
                   (command.motor_2 != 0) ||
                   (command.motor_3 != 0)) ? 1U : 0U;
          }

          if (
              (pi_motor_command_active != 0U) &&
              (PiProtocol_IsMotorCommandExpired(
                  &pi_protocol,
                  HAL_GetTick()
              ) != 0U)
          )
          {
              Motor_StopAll();
              pi_motor_command_active = 0U;
          }
      }
	  if ((HAL_GetTick() - telemetry_tick) >= 100)
	  {
	      telemetry_tick = HAL_GetTick();
          (void)PiProtocol_SendEncoderTelemetry(
              &pi_protocol,
              encoder_delta_1,
              encoder_delta_2,
              encoder_delta_3
          );
          (void)PiProtocol_SendDistanceTelemetry(
              &pi_protocol,
              stp_left_distance_mm,
              stp_right_distance_mm,
              stp_distance_valid_mask
          );
	  }
  }
  /* USER CODE END 3 */
}

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
/* USER CODE BEGIN 4 */
void HAL_UART_RxCpltCallback(UART_HandleTypeDef *huart)
{
    if (huart == &huart1)
    {
        PiProtocol_OnRxComplete(&pi_protocol, huart);
    }
    else
    {
        Stp23l_OnRxComplete(&stp_left, huart);
        Stp23l_OnRxComplete(&stp_right, huart);
    }
}

void HAL_UART_RxHalfCpltCallback(UART_HandleTypeDef *huart)
{
    Stp23l_OnRxHalfComplete(&stp_left, huart);
    Stp23l_OnRxHalfComplete(&stp_right, huart);
}

void HAL_UART_ErrorCallback(UART_HandleTypeDef *huart)
{
    if (huart == &huart1)
    {
        PiProtocol_OnUartError(&pi_protocol, huart);
    }
    else
    {
        Stp23l_OnUartError(&stp_left, huart);
        Stp23l_OnUartError(&stp_right, huart);
    }
}

/* USER CODE END 4 */
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
