sanlin19054-cyber/desktop-tutorial/electrical/Trace/Trace.h

#ifndef __Trace_H
#define __Trace_H

#define X1 GPIO_ReadInputDataBit(GPIOB,GPIO_Pin_0)
#define X2 GPIO_ReadInputDataBit(GPIOB,GPIO_Pin_1)
#define X3 GPIO_ReadInputDataBit(GPIOB,GPIO_Pin_10)
#define X4 GPIO_ReadInputDataBit(GPIOB,GPIO_Pin_11)

void Trace_Init(void);

#endif
