sanlin19054-cyber/desktop-tutorial/electrical/PWM/TIM3_PWM.c

#include "TIM3_PWM.h"
#include "MOTOR.h"


/**** TIM3 配置定时器通道1、2输出PWM方波 ***

*** 功能：实现电机调速 ***

*** PWM频率：5KHz ***

*** 修改占空比函数：TIM_SetComparex(TIMx,xxx); ***

*** 接口：
					PWMA--PA7（左电机）     PWMB--PA6（右电机）   

*** 作者：陈加油嗯 ***

***关注微信公众号学习更多单片机知识：微信搜索“陈加油嗯” ***

*/
void TIM3_PWM_Init(u16 arr,u16 psc)
{  
	GPIO_InitTypeDef GPIO_InitStructure;
	TIM_TimeBaseInitTypeDef  TIM_TimeBaseStructure;
	TIM_OCInitTypeDef  TIM_OCInitStructure;
	
	RCC_APB1PeriphClockCmd(RCC_APB1Periph_TIM3, ENABLE);	//使能定时器3时钟
 	RCC_APB2PeriphClockCmd(RCC_APB2Periph_GPIOA, ENABLE);  //使能GPIO外设
	
	//GPIO_PinRemapConfig(GPIO_PartialRemap_TIM3, ENABLE); //Timer3部分重映射  TIM3_CH2->PB5    
 
   //初始化输出TIM3两个通道PWM脉冲波形的引脚(CH1->PA6 CH2->PA7)
	GPIO_InitStructure.GPIO_Pin = GPIO_Pin_6|GPIO_Pin_7; //TIM3_CH1、CH2
	GPIO_InitStructure.GPIO_Mode = GPIO_Mode_AF_PP;  //复用推挽输出
	GPIO_InitStructure.GPIO_Speed = GPIO_Speed_50MHz;
	GPIO_Init(GPIOA, &GPIO_InitStructure);//初始化GPIO
 
   //初始化TIM3
	TIM_TimeBaseStructure.TIM_Period = arr; //设置在下一个更新事件装入活动的自动重装载寄存器周期的值
	TIM_TimeBaseStructure.TIM_Prescaler =psc; //设置用来作为TIMx时钟频率除数的预分频值 
	TIM_TimeBaseStructure.TIM_ClockDivision = 0; //设置时钟分割:TDTS = Tck_tim
	TIM_TimeBaseStructure.TIM_CounterMode = TIM_CounterMode_Up;  //TIM向上计数模式
	TIM_TimeBaseInit(TIM3, &TIM_TimeBaseStructure); //根据TIM_TimeBaseInitStruct中指定的参数初始化TIMx的时间基数单位
	
	//初始化TIM3 Channe12 PWM模式	 
	TIM_OCInitStructure.TIM_OCMode = TIM_OCMode_PWM1; //选择定时器模式:TIM脉冲宽度调制模式1
 	TIM_OCInitStructure.TIM_OutputState = TIM_OutputState_Enable; //比较输出使能
	TIM_OCInitStructure.TIM_OCPolarity = TIM_OCPolarity_High; //输出极性:TIM输出比较极性高
	
	TIM_OC1Init(TIM3, &TIM_OCInitStructure);  //根据指定的参数初始化外设TIM3 OC1
  TIM_OC2Init(TIM3, &TIM_OCInitStructure);  //根据指定的参数初始化外设TIM3 OC2
	
	TIM_OC1PreloadConfig(TIM3, TIM_OCPreload_Enable);  //使能TIM3在CCR1上的预装载寄存器
  TIM_OC2PreloadConfig(TIM3, TIM_OCPreload_Enable);
	
	TIM_Cmd(TIM3, ENABLE);  //使能TIM3
}
