sanlin19054-cyber/desktop-tutorial/(commit log)

2026-08-10 小车
    小车手册
2026-08-10 led
    小車的led部分，開、關燈，閃爍。
2026-08-10 usart和motor
    利用usart可以發送指定字元，比如“ABCDE”，motor是電機，可以讓輪子停止、左右轉，加減速。
2026-08-11 servo
    增加了舵機，固定旋轉180度，可以輔助超聲波測距。
2026-08-12 MPU6050
    MPU6050 可以感覺物體的加速度和旋轉角度變化。設置了x, y, z三個方向，MPU6050感測器透過 I2C 讀取加速度計與陀螺儀資料，將原始資料轉換成可使用的數值，並利用讀取到的加速度與角速度資料進行姿態角度計算，透過濾波融合得到 Pitch、Roll 等角度資訊。
2026-08-12 HC-SR04
    增加了超聲波測距。
2026-08-12 HC-SR04
    更新了超聲波測距，增加了接收不到高電平的情況（可能是接線出錯）。
2026-08-12 Avoidance
    小車的避障程序，發現障礙→ 停止 → 後退 → 隨機左右轉→ 強製避免連續同方向 → 前進脫離 → 重新判斷。
    [avoidance.c, avoidance.h]
2026-08-13 Track
    設置最低速度（不低於）和最高速度（不高於）。通過判斷繞彎及轉彎的程度並適當進行減速，減少了轉完後抖動的情況。除此之外，增加了“四个都是白色 → 丢线”“四个都检测到黑线 → 大面积黑线 / 路口，暂时低速直行，避免突然停止造成抖动。”的情況。
2026-08-13 Track和PID
    更新了小車的尋跡功能，加入了PID（P 負責即時修正，I 負責消除長期偏差，D 負責抑制轉彎後的左右震盪），控制結構為四路循迹->计算 error->PID ->修正量 correction ->左右轮差速 -> MOTOR。
    [track.c, track.h]
2026-08-16 Add files via upload
    小車的主要功能實現。
2026-08-16 MOTOR
    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
2026-08-16 Add files via upload
    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
    [track.c]
2026-08-16 USART
    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
2026-08-16 SERVO
    增加了舵機，可以輔助超聲波測距。
2026-08-16 main.c
    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
2026-08-16 STM32智能車遙控
    控製小車基本功能的app，鏈接藍牙即可使用
2026-08-18 Hardware
    重新做了一個版本，又改回標準庫了。
2026-08-18 README
    項目說明
2026-08-18 electrical/Hardware
    電控代碼
2026-08-18 electrical
    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
2026-08-18 hardware
    原理圖、PCB、BOM
    [BOM_STM32F1智能小车扩展板_2026-08-18.csv]
2026-08-18 遙控APP
    與小車對應的APP，鏈接藍牙即可使用。
2026-08-19 初版（HAL庫）
    小車第一版，可能是因為設備不能適配HAL庫？就算燒錄成功也不能實現功能。
2026-08-19 忽略
    忽略編譯產物、緩存、臨時文件和大體積素材。
2026-08-19 integration
    通信協議
2026-08-19 tuning
    調參記錄
2026-08-19 tuning
    小改一下
2026-08-19 tuning
    修改
2026-08-19 tuning
    修改2
2026-08-19 app修改
    改了一些詞
2026-08-19 線束表
    用于规范STM32智能小车各模块接线，方便装配、调试与维护。
    [STM32F1智能小车线束表.xlsx]
2026-08-19 上電檢查
    完成上電检查，各模塊供電、通信及驅動功能正常，系統具備調試條件。
2026-08-23 Create vision
    工創賽智能救援的視覺
2026-08-23 Delete vision
    新建錯了
2026-08-23 vision
    視覺
2026-08-23 Add README_e.md file
    改下名字，以便於區分
2026-08-23 Create README_p.md
    工創賽相關內容介紹
2026-08-23 打了個勾
    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
2026-08-23 README
    總介紹
2026-08-23 README
    UI界面
2026-08-24 calibration
    小改一下，只是讓內容看起來美觀一點
2026-08-24 視覺識別日誌
    日誌
2026-08-24 Rename calibration.json to calibration（標定文件）.json
    改名字
2026-08-24 更新
    更新了今天的識別日志
2026-08-24 Fix typo in document title from '調試日誌' to '調試日志'
2026-08-30 README
    加了點說明
2026-08-30 README
    加了說明
2026-08-30 名字打錯了
2026-08-30 更新
    到最新日期了
2026-08-31 README
    更新了很明顯的錯誤
2026-08-31 紅外調試
    增加了紅外調試記錄
2026-09-02 Add files via upload
    红外代码
2026-09-02 電機
    電機控製
2026-09-03 调试记录
    更新了红外测距调试记录
2026-09-03 識別日誌
    更新了識別日誌
2026-09-03 調試記錄
    更新了一些格式
2026-09-03 紅外測距
    紅外測距的主要文件
2026-09-03 documents
    讲解视频和说明文档
