sanlin19054-cyber/desktop-tutorial/(notices)

Notices in the files:
integration/rescue_robot_f407_ir_final_20260823/main.c:
Copyright (c) 2026 STMicroelectronics.
All rights reserved.
This software is licensed under terms that can be found in the LICENSE file
